NguyenDinhNhatNguyen/RV32i-SoC/power/README.md

# Phân tích công suất (Voltus)

Chưa có script. Sẽ chứa script Voltus cho công suất sau layout và IR drop (PWR-xx), dùng SPEF và VCD từ mô phỏng firmware. Thư mục `run*/` bị ignore.
