NguyenDinhNhatNguyen/RV32i-SoC/appendix/pnr_soc_u70/slack_summary.txt

stage=postcts_async setup_ns=0.008 hold_ns=0.020 recovery_ns=17.787 removal_ns=0.036
stage=postroute_async setup_ns=0.165 hold_ns=0.013 recovery_ns=17.774 removal_ns=0.032
