NguyenDinhNhatNguyen/RV32i-SoC/appendix/sta_soc_e60437a/sdc_9/summary.txt

top=soc_top stage=pre setup_ns=-0.022 hold_ns=-0.141 recovery_ns=7.677 removal_ns=0.020
