NguyenDinhNhatNguyen/RV32i-SoC/lec/README.md

# Kiểm tra tương đương (Conformal)

`accel_rtl2gate.do` so RTL với netlist Genus của accelerator, theo mẫu `run_lec_cg.do` của Lab 1. Không dùng dofile Genus sinh ra vì nó cần license Conformal_Ultra.

Chạy trên server: `make lec-accel` (sau `make synth-accel`). Đạt khi 0 non-equivalent.
