NguyenDinhNhatNguyen/RV32i-SoC/ref/README.md

# Thiết kế tham chiếu

`picorv32/` là submodule PicoRV32, dùng để so sánh PPA với lõi của nhóm (`make synth-compare-yosys`, `docs/yosys_compare.md`). Lấy bằng `git submodule update --init ref/picorv32`.
