NguyenDinhNhatNguyen/RV32i-SoC/appendix/synth_soc_sweep_1411/summary.md

| Chu kỳ (ns) | WNS (ns) | Chu kỳ nhỏ nhất (ns) | F_max ước lượng (MHz) | Diện tích (µm²) | Macro | Scan flop |
| --- | --- | --- | --- | --- | --- | --- |
| 10 | 0.0037 | 9.9963 | 100 | 123624.417 | 8 | 0 |
| 9 | 0.0007 | 8.9993 | 111 | 124187.486 | 8 | 0 |
| 5 | 0.0000 | 5.0000 | 200 | 129707.742 | 8 | 0 |
| 4.5 | -0.2082 | 4.7082 | 212 | 134721.667 | 8 | 0 |
