NguyenDinhNhatNguyen/RV32i-SoC/appendix/pnr_soc/slack_summary.txt

stage=postcts_async setup_ns=0.026 hold_ns=0.020 recovery_ns=17.922 removal_ns=0.023
stage=postroute_async setup_ns=-0.024 hold_ns=0.019 recovery_ns=17.871 removal_ns=0.028
