NguyenDinhNhatNguyen/RV32i-SoC/appendix/sta_soc_i2c/summary.txt

top=soc_top stage=pre setup_ns=0.529 hold_ns=-0.143 recovery_ns=18.281 removal_ns=0.028
