NguyenDinhNhatNguyen/RV32i-SoC/appendix/sta_soc_reset/summary.txt

top=soc_top stage=pre setup_ns=2.392 hold_ns=-0.147 recovery_ns=18.292 removal_ns=0.006
