NguyenDinhNhatNguyen/RV32i-SoC/appendix/sta_soc_p9/p10_p10/summary.txt

top=soc_top stage=pre setup_ns=-0.009 hold_ns=-0.143 recovery_ns=8.712 removal_ns=0.011
