NguyenDinhNhatNguyen/RV32i-SoC/docs/figures/soc_top_layout.png

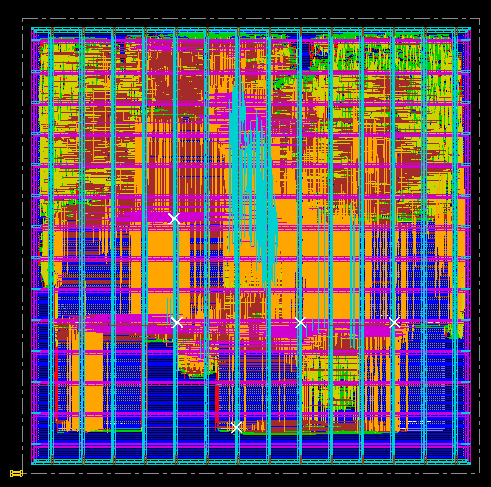
docs/figures/soc_top_layout.png
