NguyenDinhNhatNguyen/RV32i-SoC/(commit log)

2026-10-19 Initial project scaffold and week-1 infrastructure
    - Repository layout, README, team conventions, and .gitignore that keeps
    GPDK45 libraries and SRAM macro files out of version control
    - scripts/check_server.sh: survey Cadence tools, GPDK45 libraries, SRAM
    macros, and RISC-V toolchain on the school server (HT-01)
    - docs/setup_home.md: home setup with WSL2, IIC-OSIC-TOOLS Docker image,
    and OpenROAD nangate45 flow (HT-04)
    - rtl/accel: MMIO wrapper for the Lab 2 systolic array with A/B operand
    buffers, skew generator, done interrupt, and enable-based clock gating;
    behavioral core model until Lab 2 RTL is integrated (RTL-05)
    - tb/unit: wrapper testbench, 40 matrix multiplications check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
2026-10-19 Add CE434 requirements traceability matrix
    Map every assignment requirement to the repository location and owner.
    The course slides themselves stay out of this public repository.
2026-10-19 Align accelerator and Cadence flow with lab conventions
    - Accelerator: 20-bit accumulator per PE as specified in Lab 01, results
    sign-extended to 32 bits on the bus; testbench updated and passing
    - Genus script follows the Lab 01 flow: pre/post-synthesis quality gates,
    remove_assigns, mapped netlist export, optional clock gating (CG=0 for
    the baseline run)
    - Innovus flow rewritten with the Lab 02-05 command set: init_* variables,
    floorPlan, addRing/addStripe/sroute, place_opt_design with congestion
    checks, CCOpt with CLKBUFX2 excluded, OCV/CPPR and a 2W2S clock NDR;
    database checkpoints saved under DBS/ as in the labs
    - MMMC moved to a .view file read through init_mmmc_file
    - PDK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
2026-10-19 Rewrite home setup guide with pinned image and verified steps
    - Pin IIC-OSIC-TOOLS to tag 2026.10 so the team shares one toolset
    - Use Ubuntu 24.04 on WSL2, clone inside WSL, autocrlf input
    - VNC as default launch mode, port and restart notes
    - Real repo URL, sim/lint/wave targets, rv32i firmware compile check
    - ORFS nangate45 practice with fallback to openroad/orfs image
    - Troubleshooting table and no-Docker fallback
2026-10-19 Rewrite home setup around the verified WSL + Docker + VS Code workflow
    - Add scripts/eda.sh to start/stop the container and run checks from WSL
    - Default VNC port 8080 to avoid IIS on port 80
    - Docker disk image and optional Ubuntu move to drive D
    - VS Code: WSL window for git, Dev Containers attach for make, VaporView, Claude Code
    - Troubleshooting table from issues hit during setup
2026-10-19 Add VSCode workspace extensions and file associations
    Recommend extensions for Verilog, VCD waveforms, Tcl, Python, Make,
    shell, Markdown and RISC-V assembly; open MMMC .view and .sdc as Tcl.
2026-10-19 Tidy comments in accelerator RTL, flow scripts and docs
    Join wrapped comment lines, drop stale TODO markers and numbered section
    banners, and fix typos. No functional change.
2026-10-19 Stop recommending Markdown All in One
    It inserts list markers on Enter, which left stray '- ' and '2. ' lines
    in docs. markdownlint already covers Markdown checks.
2026-10-19 Update Nguyen handoff and runbook for the eda.sh home workflow
    Home commands now go through scripts/eda.sh, HT-04 is at 80% after the
    guide was verified, and each task shows its current percentage.
2026-10-19 Ignore syn/out and pnr/out flow results
    They hold netlists, SPEF and SDF derived from the GPDK45 libraries.
    Only the reports copied into appendix/ belong in the public repo.
2026-10-21 Drop unreadable QRC file and add gate-level simulation of the netlist
    Innovus could not decrypt the Lab qrc/gpdk045.tch, so fall back to
    RC estimation from the tech LEF. The school only licenses Conformal_Asic,
    which cannot run the datapath solver, so make gls-accel runs the
    40-case testbench on the synthesized netlist with Xcelium.
2026-10-21 Fix verifyGeometry for Innovus 21.1 and guard report commands
    verifyGeometry has no -type option in 21.1, which stopped the run after
    power planning. Reports and checks now warn on option errors while the
    main flow steps still stop on failure.
2026-10-21 Create CoreSiteDouble rows and use add_ndr in the Innovus flow
    gsclib045 has double-height cells, and without rows for their site
    Innovus placed 368 of them illegally (IMPSP-365). addNDR was renamed
    add_ndr, and the clock NDR now goes through a CCOpt route type.
2026-10-21 Ban the double-height BUFX2 instead of adding CoreSiteDouble rows
    BUFX2 in gsclib045 sits on CoreSiteDouble, and the optimizer inserted
    368 of them that could not be legally placed. Mark it dont_use in both
    Genus and Innovus so all cells fit the single-height rows.
2026-10-21 Add RV32I core with unit tests and assembly tests
    Bring in the 3-stage IF/EX/WB core (P3, no CSR or trap yet) with its
    ALU, register file, decoder, immediate generator and load/store lane
    logic. Unit testbenches go to tb/unit, tb_core to tb/core, the SRAM
    simulation model to tb/models, and the smoke and hazard assembly tests
    with their linker script to fw.
    tb_core and elf2hex.py now read the IMEM, DMEM and UART addresses from
    tb/core/core_tb_map.vh instead of the old soc_defs.vh, which also held
    an accelerator register map that differs from the team one.
    New Makefile targets lint-core, unit-core, fw-core and clean-core are
    appended without touching the existing ones. Core spec is in
    docs/s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
2026-10-21 Draft SoC spec with open decisions for SP-01
    Collect clock, reset, bus, address map, memory, interrupt and
    accelerator interface in one place, and list five conflicts between
    the plan, the core spec and the server check with a proposal each.
2026-10-21 Add M-mode CSRs, traps, interrupts and WFI sleep to the core (P4)
    - rv32_csr: machine-mode CSRs, 64-bit mcycle/minstret, time from mtime_i.
    CSR legality is checked in EX, reads and writes happen in WB.
    - rv32_core: trap, MRET, FENCE.I and WFI redirect from WB, interrupts
    marked on the instruction in EX, WFI sleep with if_req_o cleared
    (ENABLE_WFI_SLEEP). New ports irq_*_i, mtime_i, core_sleep_o.
    The unused_p4 lint waiver is gone.
    - riscv-tests as a pinned submodule, run with make isa-core on tb_core
    (rv32ui-p and applicable rv32mi-p all pass in 4 modes).
    - tb_core: interrupt control block, trap and sleep checks, strict timing
    for WB redirects, four M/W configurations, parallel ru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
2026-10-21 Add the RV32M unit to the core (P7)
    - rv32_muldiv: 2-cycle multiplier split into two 33x17 partial products,
    1-bit-per-cycle restoring divider (33 stall cycles), spec results for
    division by zero and overflow without special paths.
    - rv32_core: M-unit in EX behind ENABLE_M, starts only when WB is not
    waiting for a load, aborts on kill or trap. A pending interrupt can now
    abort a running division. The wb_unsup flag and its lint waiver are gone.
    - tb_core strict timing counts the M-unit stall per instruction.
    - New tests: muldiv.S and tb_rv32_muldiv. rv32um-p passes in all modes.
2026-10-21 Add a microarchitecture diagram of the 3-stage core
    The SVG shows the datapath, WB to EX forwarding, the PC redirect paths
    from EX and WB, the CSR and trap logic and the core ports. It is
    generated by docs/figures/core_microarch.py and described in
    docs/spec/core.md section 4.2.
2026-10-22 Add Dhrystone and CoreMark runs on tb_core
    make bench-core builds both benchmarks for rv32i and rv32im, runs them
    on tb_core with ENABLE_M=0 and 1, and prints CPI, Dhrystone/MHz and
    CoreMark/MHz for the timed region. CoreMark is added as a submodule.
    Results and memory sizes are in docs/bench_core.md.
2026-10-22 Add PicoRV32 as a reference and compare it with rv32_core
    PicoRV32 is added unmodified as a submodule in ref/picorv32 and run
    through the same Yosys flow in three configurations. The rough
    comparison table (cells, flip-flops, longest path, CPI, DMIPS/MHz) is
    in docs/yosys_compare.md.
2026-10-22 Add RTL and testbenches for APB3 Timer (CLINT) and GPIO - Implement 64-bit mtime/mtimecmp split into two 32-bit halves, optimized for synthesis and clock gating. - Add 2-stage CDC synchronizer for GP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
2026-10-22 Add SRAM macro notes and a server script to summarize the macro
    Walk through what the macro needs in RTL, Genus, LEC, GLS, Innovus,
    STA and DRC/LVS, list what to check on the server and what to ask the
    lecturer. macro_info.sh prints pins, layers, blockages and corners
    without copying the library files.
2026-10-22 Record that the macro GDS and CDL are not required
    The lecturer confirmed on 22/10 that the project stops at a normal PD
    flow without fabrication, so final checks stay in Innovus and the macro
    is checked through its LEF only.
2026-10-23 Run riscv-arch-test against Spike and record results
    - Filter pmp32 out of the RISCOF test list, since the core has no
    PMP and no S/U-mode. arch-core-dut now runs all 15 privilege tests.
    - Make arch-core fail when report.html has Failed tests, because
    riscof run always exits 0.
    - Clear the breakpoint bit in SET_REL_TVAL_MSK, since the core
    writes mtval = 0 on ebreak.
    - Record results (M0W1 53/55, M1W1 61/63) and tool versions, explain
    the ebreak and misalign-jal-01 mismatches, fix install commands.
2026-10-23 Write PC to mtval on ebreak and match Spike load address
    - ebreak now writes mtval = PC of the ebreak instruction (D-035).
    Update core.md 4.8, trap.S test 31 and restore the default
    SET_REL_TVAL_MSK in model_test.h.
    - Build tb_core for arch-test with IMEM and RESET_PC at 0x80000000,
    the same load address as Spike, so misalign-jal-01 signatures match.
    link.ld, arch_run.sh and elf2hex.py --imem-base follow it.
    - Keep the pmp32 filter in the Makefile and document why the ISA yaml
    cannot exclude those tests.
    - arch-core now passes 55/55 (M0W1) and 63/63 (M1W1).
2026-10-23 WIP: Add home timing flow with Nangate45 and OpenSTA
    Yosys maps rv32_core to the open Nangate45 library and OpenSTA reports the critical path and F_max. Baseline numbers and work in progress are in docs/timing_core.md. RTL changes are not committed yet.
2026-10-23 Add PPA table script for Genus and Innovus reports
    scripts/ppa_table.py reads qor, area, power, gates and clock gating
    reports from Genus and area, power, timing summary and density from
    Innovus, then prints one Markdown table with GE, F_max estimate,
    energy per cycle and EPI. Tested on the accelerator reports in
    appendix/synth_accel and appendix/pnr_accel.
2026-10-23 Add draft report chapter for the RV32I core
    docs/report/core.md covers goals and ISA, the 3-stage microarchitecture,
    ten key design decisions, verification method and results, benchmarks,
    home timing trends and known limits. Every number cites a file in the
    repo. Genus and Innovus numbers are left as "chờ STA-04".
2026-10-23 Add oral exam Q&A for the RV32I core
    docs/report/core_qa.md has 30 short questions and answers on the
    pipeline, hazards, precise exceptions, interrupts, CSR, WFI, RV32M,
    the valid/ready bus and verification. Each answer points to the
    design decision or document behind it.
2026-10-24 add RTL and testbench for UART
2026-10-24 Add soc_top with reset sync and connect UART
2026-10-25 Translate code comments and test output to English
    All comments in RTL, testbenches, firmware, scripts and Cadence/Yosys
    scripts are now English. Test and script messages are English too, and
    the failure marker LOI becomes ERROR (bus_run.sh and soc_run.sh grep for
    it). README and docs stay Vietnamese. Also rewrite .gitignore in English
    and ignore more flow outputs and course material.
2026-10-25 Reorganize docs and add folder READMEs
    Move the content of nguyen_handoff.md and runbook_nguyen.md into topic
    docs and delete them. flow_notes.md now covers the full school flow,
    lessons from 21/10 and common errors. Add spec/periph.md (Timer, UART,
    GPIO, IRQC, boot ROM, top-level pins) and spec/accel.md, a docs index,
    and a README in each top-level folder in place of .gitkeep files.
2026-10-26 Add IRQC interrupt controller and connect it in soc_top
2026-10-26 Use plain abc in the Nangate flow and stop on tool errors
    Yosys in the IIC-OSIC-TOOLS 2026.10 container does not accept "abc -fast".
    The generic abc step only maps logic before abc -liberty, so plain abc is enough.
    nangate_run now prints the last 20 lines of yosys.log or sta.log and fails when a
    tool fails. docs/timing_core.md records the new numbers (M0 2.855 ns, M1 3.007 ns).
2026-10-26 Add DMA as the second bus master (ENABLE_DMA)
2026-10-26 Add soc_top benchmarks and accelerator speedup (EVA-01)
    - make bench-soc runs Dhrystone, CoreMark and fw/bench/accel_bench.c on tb_soc
    with ENABLE_M=0 and 1. The benchmark sources build with -DBENCH_SOC (UART with
    TXF polling and BAUDDIV = 1, flush before tohost).
    - scripts/bench_soc_mon.v is a second simulation root that counts bus stalls,
    SB/SH stores, fetch stalls and APB accesses in each measured region.
    - scripts/bench_soc_run.sh accepts the expected CoreMark "10 secs" ERROR line.
    - accel_bench.c multiplies 16x16 int8 matrices in software, on the accelerator
    with polling, and with the IRQC interrupt, and checks all results match.
    - docs/bench_soc.md: CPI, DMIPS/MHz, CoreMark/MHz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
2026-10-26 Take interrupts right after an MIE write and skip WFI sleep when pending (D-038)
    The core blocked interrupts on the instruction after any mstatus/mie write, so
    setting MIE and clearing it on the next instruction never took a pending
    interrupt, and the race-free WFI wait loop in accel_bench.c spun forever.
    rv32_csr now forwards the MIE/mie value being written in WB to the interrupt
    check of EX, and WFI does not sleep when (mip & mie) != 0 already.
    - fw/tests/asm/wfi_pending.S: pending interrupt before WFI with MIE = 0 and 1,
    csrs/csrc window, wait loop, csrs mie. tb_rv32_csr checks the forward.
    - accel_bench.c: drop the nop workaround.
    - bench-core and bench-soc label each result line with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
2026-10-26 Add UART bootloader in the boot ROM (D-039)
    fw/boot/boot.S loads a program over UART into IMEM and jumps to it.
    Protocol: MAGIC, SYNC, addr, len, data, CRC-32, with ACK/NAK after the
    header and after the CRC. Addresses outside IMEM get a NAK before any
    write. The boot strap gpio_i[0] selects UART boot (1, 1 s timeout) or a
    direct jump to IMEM (0, as the base ROM), so tb_soc runs stay fast.
    - scripts/gen_boot_rom.py regenerates rtl/mem/boot_rom_init.vh (127 of
    256 words) and scripts/uart_pack.py packs or sends a .bin
    - make boot-gen, make sim-boot: tb/boot/tb_boot.v with a host model,
    6 tests (load, bad CRC, bad address, timeout, strap 0, real baud)
    - bench-soc vvp now depends on boot_ro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
2026-10-26 Read expected boot ROM words from boot_rom_init.vh in tb_imem_port
    The check compared fetches from the boot ROM with the base ROM contents
    (word 0 = jalr, others 0), so unit-bus failed with the UART bootloader.
    A function now includes boot_rom_init.vh like boot_rom.v does.
    Changed with Phat's approval.
2026-10-26 Load DMEM and multi-segment ELF programs in the bootloader (D-040)
    The header gets an entry word (in the CRC). 0xFFFFFFFF means more
    segments follow, any other value ends the load and must be a word
    aligned IMEM address. Each segment must sit inside IMEM or inside DMEM
    (from soc_map.vh), anything else or a segment across a region end gets
    a NAK before any write.
    - uart_pack.py takes an ELF and sends one packet per loaded section
    (.text, .rodata, .data, ...) at its run address, the last one with
    the ELF entry. A .bin still works as one packet.
    - sim-boot: new celf test loads a C program with a non-zero global,
    a constant table and a string in DMEM. badaddr adds 4 NAK cases
    (DMEM over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
2026-10-26 Add the interrupt and WFI section to the core report
2026-10-26 Add the UART bootloader section to the core report
2026-10-26 Add viva questions on interrupts, bootloader, SoC performance and branch prediction
2026-10-27 Add the Genus, Conformal and GLS flow for rv32_core
2026-10-27 Add make unit-periph for the Timer, GPIO, UART and IRQC testbenches
2026-10-29 PD-01: Hoàn thành full flow Innovus Lab 2, fix CTS skew <= 80ps
2026-10-29 Ép Git theo dõi thư mục appendix
2026-10-29 chore(soc): finalize PD-02 floorplan and complete PNR flow for soc_top with reports, spef, netlist and gds
2026-10-29 Add Genus results for soc_top and each SoC block and give the block reset port a driver
2026-10-31 Fix the soc_top PnR flow and the PD-02 core size
    run_all.tcl picks the block with TOP, so make pnr-accel works again and
    the new make pnr-soc sources soc_floorplan.tcl. CLKBUFX2 is banned right
    after init_design instead of only before CTS. The core is 394 x 395 um
    from the real Genus area, the 29/10 size counted the macros twice. Add
    docs/pnr_soc_status.md to track the PnR items, the boot strap pin in the
    SoC spec (SP-02), and move the layout image to docs/figures.
2026-11-03 feat(periph): Done Unit Test RTL-13 (PWM, SPI) and RTL-14 (I2C)
2026-11-03 docs: add register description for SPI and PWM (RTL-13)
2026-11-04 Report recovery and removal in the PnR flow and add a hold margin
    Removal on the buffered reset net had only 6 ps left before layout, and
    timeDesign does not list recovery or removal on their own. run_all.tcl
    now writes recovery and removal reports after CTS and after route, plus
    reports/slack_summary.txt with the worst slack of all four checks, and
    fixes hold with a 20 ps target. Also point the docs at ~/RV32i-SoC, the
    real clone folder on the shared server account.
2026-11-07 Connect SPI and PWM to soc_top and fix their lint warnings
2026-11-07 Place the SPI and PWM pins and grow the soc_top core for them
    soc_top has 5 new pins since 4890077 (spi_sclk, spi_mosi, spi_miso,
    spi_cs_n, pwm_o). They go on the left edge with the other inputs and
    UART, 41 pins there and 64 on the right. SPI and PWM add about 1800 um2
    of logic, so the core grows from 394 x 395 um to 397 x 400 um to keep
    70% density.
2026-11-07 Update the README status to the 07/11 regression
    fw-core 112/112, fw-soc 129/129 with SPI and PWM, sim-boot and lint
    clean. I2C has no RTL on main yet.
2026-11-07 Add lint-periph, lint-all and the SPI, PWM unit tests with a lint log
2026-11-07 Settle the BTB and DMA defaults and check the sys_bus round-robin order
2026-11-07 Grow the soc_top core for the DMA and connect the SPI and PWM pins in tb_boot
2026-11-09 Fix PWM race condition, add SPI modes and I2C FSM, translate TB to English
2026-11-10 Wire I2C into soc_top and fix the SPI CPHA=1 timing and I2C repeated START
2026-11-11 Update soc_top.md for the ninth lint-soc build and the I2C area
2026-11-11 Add SPI, PWM and I2C to synth-blocks and bring help and docs up to date
2026-11-12 Move the i2c_apb FSM localparams out of generate for Genus
2026-11-12 Add the 12/11 soc_top synthesis and STA reports with DMA, SPI, PWM and I2C
2026-11-13 Add the remaining DRC fix with a routed area to flow_notes
2026-11-13 Add the second verified case of the DRC fix with a routed area to flow_notes
2026-11-13 Add LEC flow files for soc_top (LEC-01)
2026-11-13 Declare the SRAM macro as a black box before read design in the LEC flow
2026-11-14 Add LEC flow and first run of soc_top against the 12/11 netlist (LEC-01)
2026-11-14 Add LEC flow for soc_top and apb_bridge with trial run results
2026-11-14 Remove constant register bits in uart, spi, i2c and core
